ArthurLCastro/SunFlollower/README.md

# Projeto SunFlower

## Descrição:

Repositório destinado ao compartilhamento dos códigos e arquivos do projeto **SunFlower** referente à cadeira de Prototipação Eletrônica do 4º Período Subsequente do IFPE.

Alunos: Arthur Castro; Henrique Martins; Luís Fernando

Professores: Marcus Vinícius; Domingos Sávio

----------

## *Creative Commons*

Sinta-se livre para copiar, redistribuir em qualquer suporte ou formato, adaptar, transformar e criar a partir do material. Você deve apenas dar o crédito apropriado:

*Arthur Lima de Castro*
</br>
arthur.castro07@gmail.com
</br>
[GitHub - ArthurLCastro](https://github.com/ArthurLCastro)

*Henrique Leão Martins*
</br>
leaomartinshenrique@gmail.com
</br>
[GitHub - HMLeao](https://github.com/HMLeao)

*Luís Fernando Araújo Farias*
</br>
brksluis@gmail.com
</br>
[GitHub - LuisLFAF](https://github.com/LuisLFAF)

<br />Este trabalho está licenciado com uma Licença <a rel="license" href="http://creativecommons.org/licenses/by-nc-sa/4.0/">Creative Commons - Atribuição-NãoComercial-CompartilhaIgual 4.0 Internacional</a>.

[Licença](https://creativecommons.org/licenses/by-nc-sa/4.0/legalcode)
