ArthurLCastro/SunFlollower/Esquemas - Placas/PlacaSensores.pdf

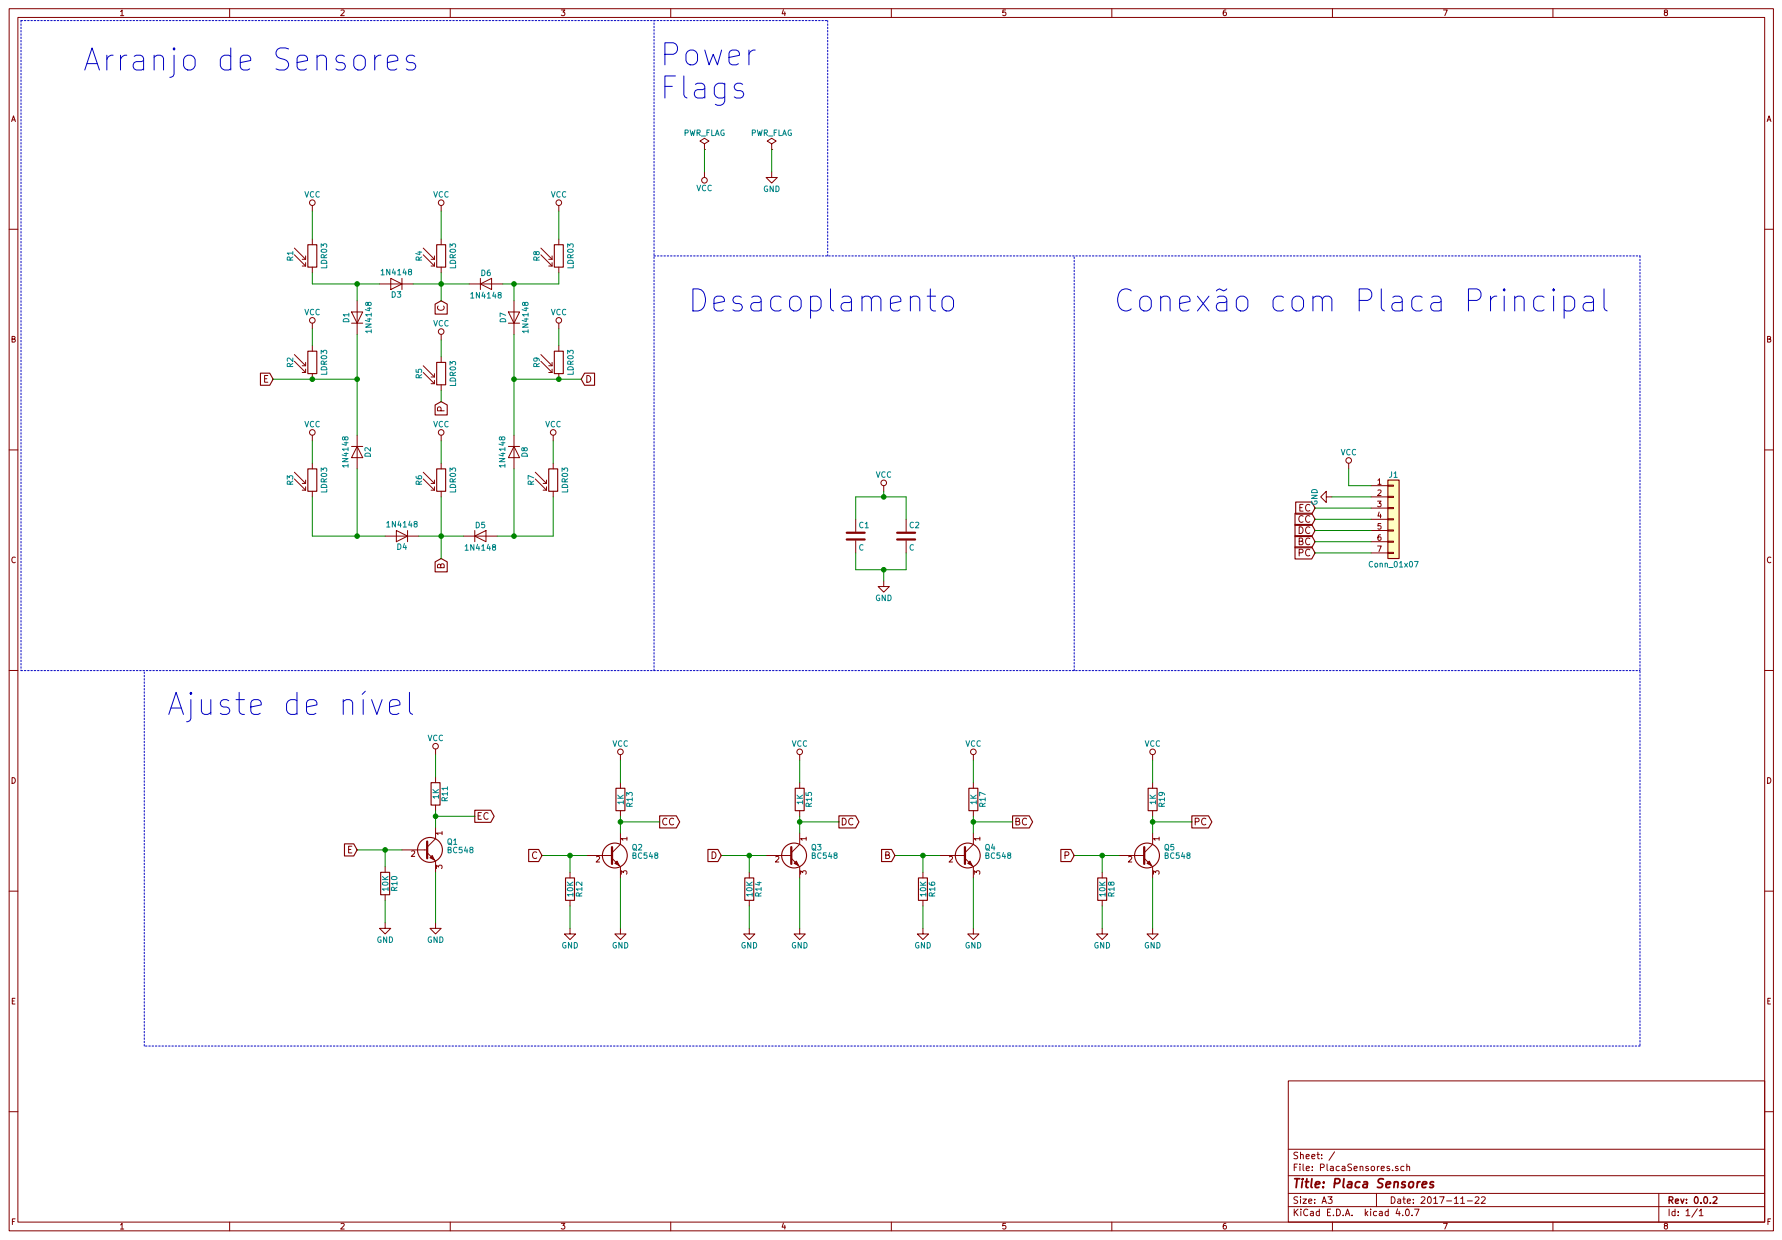
[picture p13: page 1]
