ArthurLCastro/SunFlollower/Esquemas - Placas/SunFlower.pdf

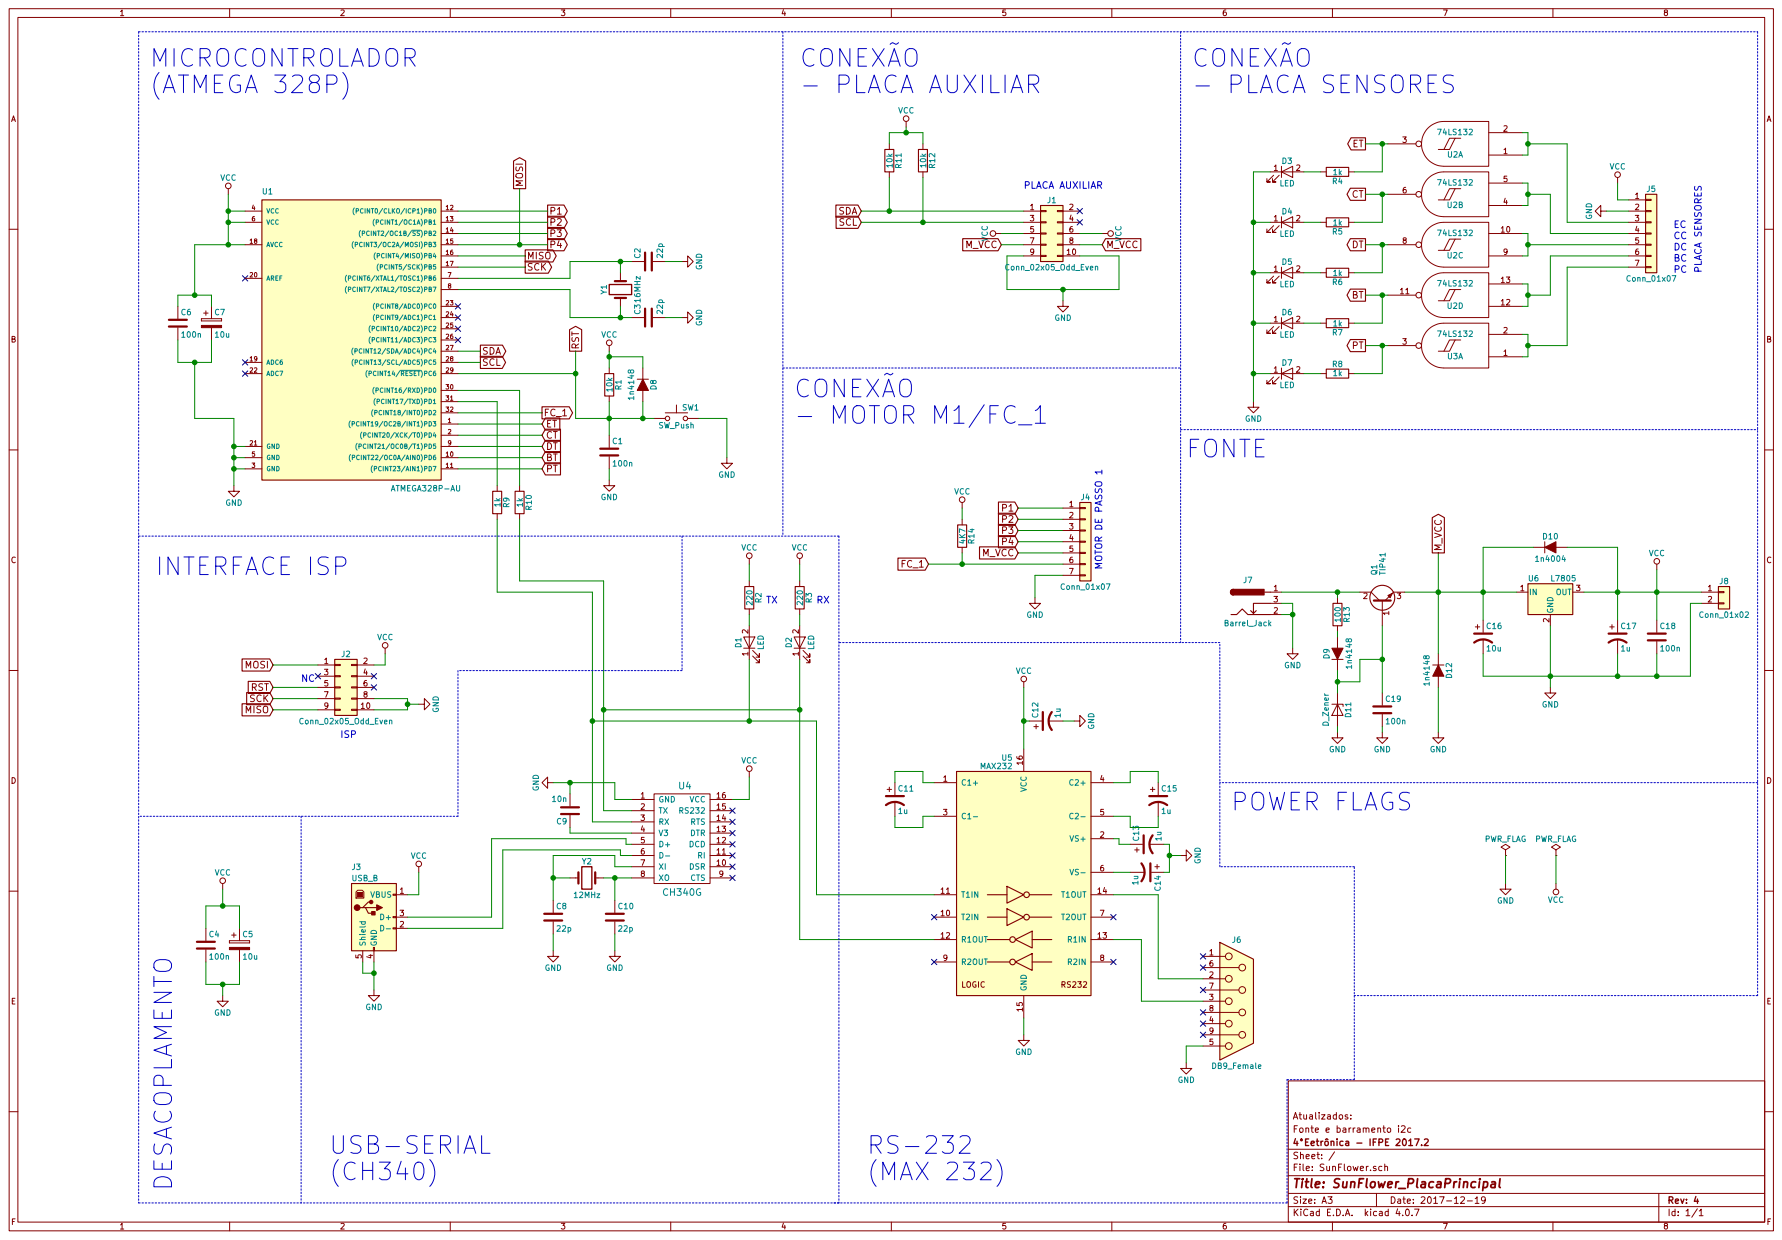
[picture p14: page 1]
