ArthurLCastro/SunFlollower/Simulações - Proteus/NEWSUN.PDF

## LDR1

## LDR2

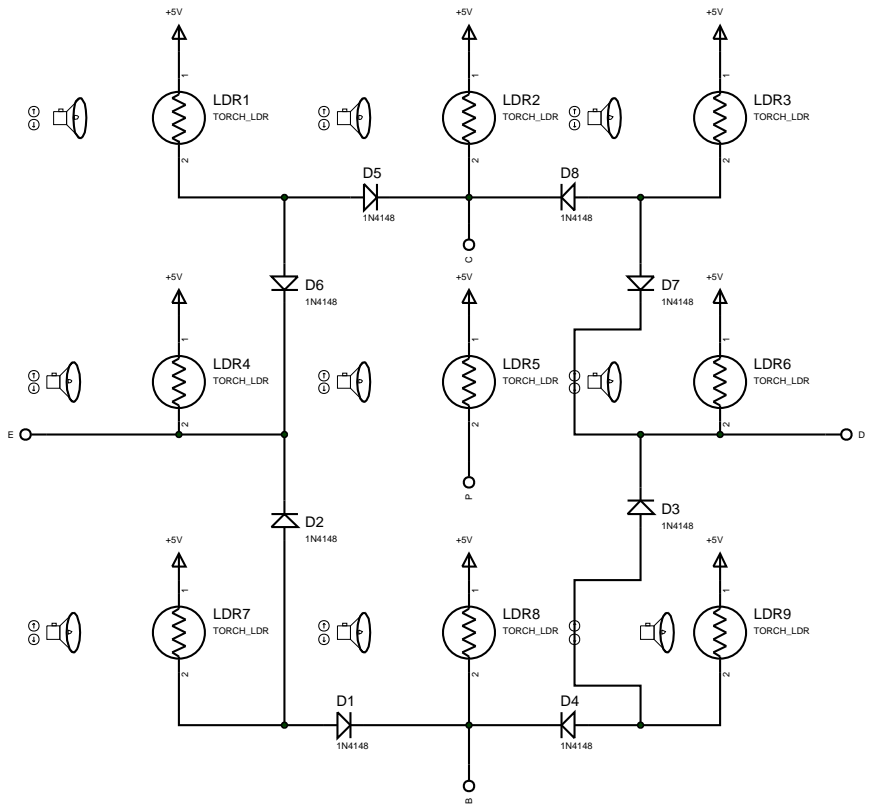
[picture p15: page 1]

R6
R8

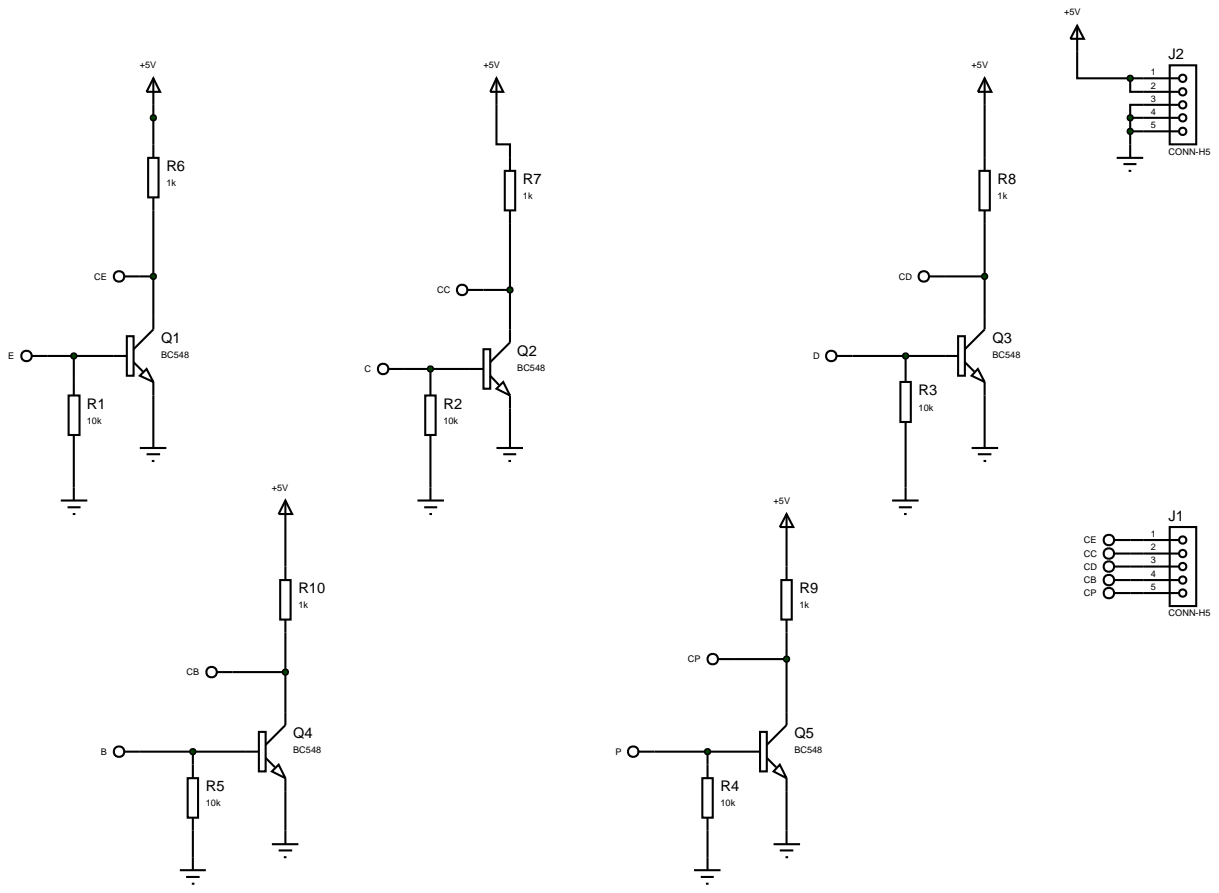
[picture p16: page 2]
