ArthurLCastro/SunFlollower/(list of files, drawings)

Other design files:
Simulações - Proteus/NEWSUN.pdsprj
SunTracker.pdsprj
