ArthurLCastro/SunFlollower/(commit log)

2017-10-16 Projeto SunTracker - versão 1
    [SunTracker.pdsprj]
2017-10-16 Upload de projetos
    [NEWSUN.pdsprj]
2018-04-11 Adição de Licença Creative Commons
2018-04-12 Atualização do README.md
    Troca de nomes "SunFlollower" por "SunFlower"
    Adição do Creative Commons
2018-04-12 Ulpoad de "Esquemas das Placas"
